gcswales/6502-CRAB-APPLE/ELECTRONICS/6502_SBC.jpg

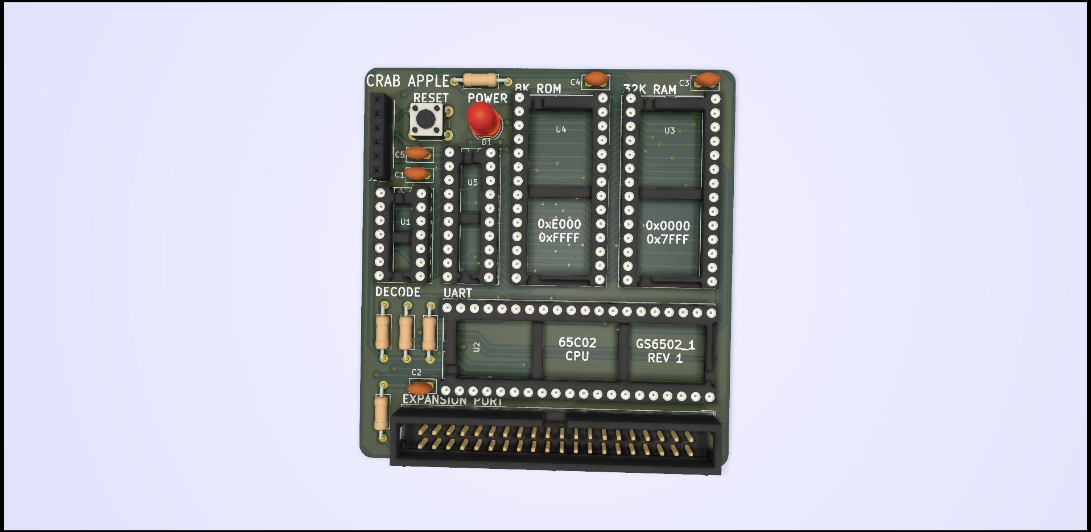
ELECTRONICS/6502_SBC.jpg
