gcswales/6502-CRAB-APPLE/ELECTRONICS/MEMORY_MAP3.odt

A15 A14 A13 RAM_CS RAM_OE ROM_CS ROM_OE IO_CS DESCRIPTION

1 1 1 1 1 0 0 1 ROM 4K

1 1 1 1 1 0 0 1 ROM 4K

1 1 0 1 1 0 1 0 I/O

1 1 0 1 1 0 1 0 I/O

1 0 1 1 1 1 1 1 FREE

1 0 1 1 1 1 1 1 FREE

1 0 0 1 1 1 1 1 FREE

1 0 0 1 1 1 1 1 FREE

0 1 1 0 0 1 0 1 RAM 4K

0 1 1 0 0 1 0 1 RAM 4K

0 1 0 0 0 1 1 0 RAM 4K

0 1 0 0 0 1 1 0 RAM 4K

0 0 1 0 0 1 1 1 RAM 4K

0 0 1 0 0 1 1 1 RAM 4K

0 0 0 0 0 1 1 1 RAM 4K

0 0 0 0 0 1 1 1 RAM 4K

0xE000 – 0xFFFF - ROM

0xC000 – 0xDFFF - I/O

0x8000 – 0xBFFF - FREE

0x0000 – 0x7FFF - RAM

SPECIFICALLY THE UART IS MAPPED TO 0xC010 AND 0xC011 (A4 LINE).

A15 | A14 | A13 | A12 | A11 | A10 | A9 | A8 | A7 | A6 | A5 | A4 | A3 | A2 | A1 | A0 | ADDRESS | DESCRIPTION
1 | 1 | 1 | x | x | x | x | x | x | x | x | x | x | x | x | x | 0xE000 - 0xFFFF | 8K ROM
1 | 1 | 0 | x | x | x | x | x | x | x | x | x | x | x | x | x | 0xC000 - 0xDFFF | 8K I/O MAPPED RANGE
1 | 0 | x | x | x | x | x | x | x | x | x | x | x | x | x | x | 0x8000 – 0xBFFF | 16K FREE
0 | x | x | x | x | x | x | x | x | x | x | x | x | x | x | x | 0x0000 – 0x7FFF | 32K RAM
1 | 1 | 0 | x | x | x | x | x | x | x | x | 1 | x | x | x | 0 | N/A | UART ADDRESS 0
1 | 1 | 0 | x | x | x | x | x | x | x | x | 1 | x | x | x | 1 | N/A | UART ADDRESS 1
