gcswales/6502-CRAB-APPLE/ELECTRONICS/BOM/6502_SBC.ods

Id | Designator | Package | Quantity | Designation | Manufacturer | Manufacturer Code | Supplier | Supplier Code | Cost | Total | Comments
1 | D1 | LED_D5.0mm | 1 | LED | CREE LED | C503B-RBN-CW0Z0AA2 | MOUSER | 941-C503BRBNCW0Z0AA2 | £0.130 | £0.130 | POWER LED
2 | J2 | IDC-Header_2x20_P2.54mm_Vertical | 1 | Conn_02x20_Odd_Even | 3M ELECTRONIC | 30340-6002HB | MOUSER | 517-30340-6002 | £1.360 | £1.360 | EXPANSION BUS CONNECTOR
3 | U1 | DIP-14_W7.62mm_Socket_LongPads | 1 | 7400 | TEXAS INSTRUMENTS | SN74HC00AN | MOUSER | 595-SN74HC00AN | £0.528 | £0.528 | ADDRESS DECODE LOGIC (4XNAND)
4 | SW1 | SW_PUSH_6mm | 1 | SW_Push | CUI DEVICES | TS02-66-55-BK-160-LCR-D | MOUSER | 179-TS026655BK160LCR | £0.088 | £0.088 | RESET BUTTON
5 | R5,R2,R1,R4,R3 | R_Axial_DIN0207_L6.3mm_D2.5mm_P10.16mm_Horizontal | 5 | 1K | YAGEO | CFR-25JB-1K0 | MOUSER | 603-CFR-25JB-1K0 | £0.088 | £0.440 | RESISTORS
6 | J1 | PinSocket_1x06_P2.54mm_Vertical | 1 | Conn_01x06_Female | HARWIN | M20-7820646 | MOUSER | 855-M20-7820646 | £1.090 | £1.090 | ICSP CONNECTOR & USB/UART
7 | C4,C3,C2,C1,C5 | C_Disc_D5.0mm_W2.5mm_P2.50mm | 5 | 100N | VISHAY | K104M15X7RF53K2 | MOUSER | 594-K104M15X7RF53K2 | £0.202 | £1.010 | DECOUPLING CAPS
8 | U2 | DIP-40_W15.24mm_Socket_LongPads | 1 | 6502 | WESTERN DESIGN CENTRE | W65C02S6TPG-14 | MOUSER | 955-W65C02S6TPG-14 | £9.510 | £9.510 | 65C02 CPU
9 | U3 | DIP-28_W15.24mm_Socket_LongPads | 1 | AS6C62256-55PCN | ALLIANCE MEMORY | AS6C62256-55PCN | MOUSER | 913-AS6C62256-55PCN | £3.610 | £3.610 | 32K SRAM CHIP
10 | U4 | DIP-28_W15.24mm_Socket_LongPads | 1 |  | MICROCHIP | AT28C64B-15PU | MOUSER | 556-AT28C64B15PU | £5.140 | £5.140 | 8K EEPROM
11 | U5 | DIP-20_W7.62mm_Socket_LongPads | 1 | PIC18F14Q41 | MICROCHIP | PIC18F14Q40-I/P | MOUSER | 579-PIC18F14Q40-I/P | £1.610 | £1.610 | PIC18F – BIOS
12 | U1 | DIP-14_W7.62mm_Socket_LongPads | 1 | 14-PIN IC SOCKET | MILL-MAX | 110-44-314-41-001000 | MOUSER | 575-11044314 | £0.915 | £0.915 | 14-PIN IC SOCKET (7400)
13 | U2 | DIP-40_W15.24mm_Socket_LongPads | 1 | 40-PIN IC SOCKET | MILL-MAX | 110-44-640-41-001000 | MOUSER | 575-11044640 | £2.220 | £2.220 | 40-PIN IC SOCKET (CPU)
14 | U3,U4 | DIP-28_W15.24mm_Socket_LongPads | 2 | 28-PIN IC SOCKET | MILL-MAX | 110-99-628-41-001000 | MOUSER | 575-199628 | £1.680 | £3.360 | 28-PIN IC SOCKET (RAM & ROM)
15 | U5 | DIP-20_W7.62mm_Socket_LongPads | 1 | 20-PIN IC SOCKET | MILL-MAX | 110-99-320-41-001000 | MOUSER | 575-199320 | £1.200 | £1.200 | 20-PIN IC SOCKET (PIC18)
 |  |  |  |  |  |  |  |  |  | £32.211
 |  | PRICES & AVAILABILITY AS OF 13/01/23
