gcswales/6502-CRAB-APPLE/(threads)

Thread 1 (2023-12-04):

W65C02 Pin 1 ?

Mike-K8LH, 2023-12-04:
It seems pin 1 on non-WDC CPU's is VSS (ground) but pin 1 on WDC CPU's is an output.  Shouldn't that pin be 'open' or 'no connect' instead of grounded when using WDC CPU's?

gcswales, 2023-12-06:
> It seems pin 1 on non-WDC CPU's is VSS (ground) but pin 1 on WDC CPU's is an output. Shouldn't that pin be 'open' or 'no connect' instead of grounded when using WDC CPU's?

Aaaaah!
You're right.
Best thing is there's no 'one size fits all' solution. I'll amend the documentation to make this clear.
It will only be a problem when trying to use interrupts and WOZ didn't like the 6502 interrupts.
Possible work-around (botch) is to bend pin 1 when fitting the 6502 so pin 1 does not sit in the DIP socket contact.
best regards,
Geoffrey.

Mike-K8LH, 2023-12-06:
Greetings, Geoffrey:

May I say this is a 'brilliant' project? Thank you. I built a board and installed Krusader 1.3 firmware and it seems to work quite well, except I'm not sure Xon/Xoff is working correctly. If you have time, may I impose to ask a couple questions, please?

(1) Which versions of MPLABX and XC8 did you use? I'm using MPLABX version 6.10 with XC8 version 2.45 and getting some "conflicting type" errors for 'putch' and 'getch' functions when compiling the program. I changed the type for those functions in order to compile without errors.

(2) Which PIC device did you use? The schematic shows 18F15Q41 but the project file seems to be for the 18F14Q40. I'm actually using 18F16Q40 but I'm not sure it's 100% compatible with your program, as is.

(3) Should the 256 byte RX buffer and Xon/Xoff method allow me to download large programs (text) without having to use character and line delays in my TeraTerm terminal program?

Please don't feel obligated to answer. I will understand.

Cheerful regards, Mike McLaren, K8LH (Michigan, USA)

From: "Geoffrey Swales" ***@***.***>
To: "gcswales/6502-CRAB-APPLE" ***@***.***>
Cc: "Mike-K8LH" ***@***.***>, "Author" ***@***.***>
Sent: Wednesday, December 6, 2023 8:58:10 AM
Subject: Re: [gcswales/6502-CRAB-APPLE] W65C02 Pin 1 ? (Issue #1)

It seems pin 1 on non-WDC CPU's is VSS (ground) but pin 1 on WDC CPU's is an output. Shouldn't that pin be 'open' or 'no connect' instead of grounded when using WDC CPU's?

Aaaaah!
You're right.
Best thing is there's no 'one size fits all' solution. I'll amend the documentation to make this clear.
It will only be a problem when trying to use interrupts and WOZ didn't like the 6502 interrupts.
Possible work-around (botch) is to bend pin 1 when fitting the 6502 so pin 1 does not sit in the DIP socket contact.
best regards,
Geoffrey.

—
Reply to this email directly, [ https://github.com/gcswales/6502-CRAB-APPLE/issues/1#issuecomment-1842943363 | view it on GitHub ] , or [ https://github.com/notifications/unsubscribe-auth/AJGRSDVY5FPEUTNZUYEHWNTYIB2XFAVCNFSM6AAAAABAGM4BASVHI2DSMVQWIX3LMV43OSLTON2WKQ3PNVWWK3TUHMYTQNBSHE2DGMZWGM | unsubscribe ] .
You are receiving this because you authored the thread. Message ID: ***@***.***>

Mike-K8LH, 2023-12-06:
BTW, Geoffrey, I use a jumper on pin 1 to ground (the yellow jumper below) to support both WDC and non-WDC CPU's.

Take care. Cheerful regards, Mike McLaren

gcswales, 2023-12-15:
Hi Mike,

Thanks for that; compliments are ALWAYS welcome!

I'm at work at the moment but I will look into the XON/XOFF issue. I know it was working when I tested it as it became evident early on that some type of flow control was needed when trying to 'paste' code using WOZMON. Initially I used RTS/CTS but ran out of pins on the PIC so resorted to XON/XOFF which works well with the type of ASCII data the Apple I was limited to (7-bits).

3) The 256 rx buffer solves a problem with cheaper USB2UART modules that only respond to flow-control between USB packets, so they will continue to dump their current data packet before halting. The XON/XOFF is to stem the flow when it is a large torrent of data.

2) 18f15q41... maybe another mistake. I'll look into this. I know I changed the PIC a few times during development. Using at 18f14q40 (16k/1k) or a 18f16q40 (64k/4k) should not make a difference. Both devices have identical peripherals it's only a memory difference.

1) I'll get back to you on that. I remember that Microchip changed some definitions in it's XC.H file for the newer versions of XC8 which was very annoying. Also they promote the use of universal variable types; for example U8INT, S32INT as these are portable across different platforms and processor sizes. However, in their libraries they continue to use things like LONG SHORT LONG, etc!?!

I've never heard of Krusader 1.3 but I've just Googled it and it sounds interesting so I'll give it a go.

I would be interested to hear any ideas for improvement on the Crab Apple. It was a 'first attempt' and since then I've been working on something a bit more sophisticated. However, I'd like to go back a revise the Crab Apple to produce the Crab Apple II. Rather than use an EPROM I fit 2 x 32k SRAM. The PIC uploads the EPROM images via Xmodem then pumps it to the SRAM during boot (takes 0.6ms). This speeds up development and makes the whole thing a bit more flexible.

Let me know how you get on.

Best regards,

Geoffrey.

gcswales, 2023-12-15:
Hi Mike,
To answer your first question:
Hi Mike,

I'm using MPLAB X IDE v6.00 on Mint Linux so it may be a different version on Windows.

The code is written in C using Microchip XC8 v2.36.

Mike-K8LH, 2023-12-15:
I have ideas and some working examples.  Crab Apple I only lacks a pin to enable/disable memory in order to support boot loader, rom emulator, and programmer functions.  I have something like this using a Nano (see below).  Crab Apple II might benefit from using a 28-pin 18F27Q43.

Interested in communicating directly?  k8lh and arrl.net

Cheerful regards...  Happy Holidays...

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

micha-uhl, 2024-09-24:
Hallo, I´m Michael, 69. Very interesting version of the Apple1. I have ordered some PCBs from pcbway. I have also build the RC6502 Apple 1 replica. So I have a second MOS6502 and EEPROM with Basic, Crusader and Wozmon over. Now I'm looking for someone who can program the PIC for me.
regards

Mike-K8LH, 2024-09-24:
Hi, Michael.

May I ask where you're located, please? If you're in the United States, perhaps I can help.

Cheerful regards,

Mike McLaren, K8LH (Michigan, USA)

From: "micha-uhl" ***@***.***>
To: "gcswales/6502-CRAB-APPLE" ***@***.***>
Cc: "Mike-K8LH" ***@***.***>, "Author" ***@***.***>
Sent: Tuesday, September 24, 2024 10:04:05 AM
Subject: Re: [gcswales/6502-CRAB-APPLE] W65C02 Pin 1 ? (Issue #1)

Hallo, I´m Michael, 69. Very interesting version of the Apple1. I have ordered some PCBs from pcbway. I have also build the RC6502 Apple 1 replica. So I have a second MOS6502 and EEPROM with Basic, Crusader and Wozmon over. Now I'm looking for someone who can program the PIC for me.
regards

—
Reply to this email directly, [ https://github.com/gcswales/6502-CRAB-APPLE/issues/1#issuecomment-2371390692 | view it on GitHub ] , or [ https://github.com/notifications/unsubscribe-auth/AJGRSDTJOR66ZVAR37WPVIDZYFWNLAVCNFSM6AAAAABOYMQI6KVHI2DSMVQWIX3LMV43OSLTON2WKQ3PNVWWK3TUHMZDGNZRGM4TANRZGI | unsubscribe ] .
You are receiving this because you authored the thread. Message ID: ***@***.***>

micha-uhl, 2024-09-24:
Sorry, I´m from Germany

gcswales, 2024-09-24:
Hi Michael,
If you send me your address I'll ship you one.
Best regards,
Geoffrey.

micha-uhl, 2024-09-24:
Hi Geoffrey, that's great. Sent you Email.
regards Michael

Mike-K8LH, 2024-09-25:
Hi Geoffrey.  Would you consider opening up the 'discussions' tab on your github project?  I'd love to talk about some ideas, if you have the time and interest.

Cheerful regards...

micha-uhl, 2024-09-25:
One more question, can I also use an 8x8 SRAM? That would be closer to the original.

Regards Michael

gcswales, 2024-09-25:
Hi Michael,  yes you can fit an 8k x 8 SRAM. The address will wrap-around so the 8k will appear 4 times in the 32k space.
However, 8k SRAM is probably more expensive (rare) than 32k chips and you will be limiting what programs you can run.
I have a newer design which uses 2 x 32k SRAM chips and the PIC dumps the an 8k ROM image into RAM during boot. It takes about 200ms. Also the PIC runs XMODEM so I can quickly upload code to the board which is much faster, when developing code, than pulling an EEPROM out and programming it.

gcswales, 2024-09-26:
> Hi Geoffrey. Would you consider opening up the 'discussions' tab on your github project? I'd love to talk about some ideas, if you have the time and interest.
>
> Cheerful regards...

Done, hit me!

micha-uhl, 2024-10-15:
Now I have finished the part, but it doesn't work properly.
1. Problem, no LF. I can set it in Windows with TeraTerm
2. The boot menu is displayed and I can also make settings. After the start, the backslash appears. No keyboard inputs are accepted.
3. I used an 8k x 8 SRAM. It may be that it doesn't work because of that. I have ordered a 62256 to see, what happens.

gcswales, 2024-10-15:
Hi Michael,
1) WOZMON and many apple I programs only send CR and do not follow it with a LF. The PIC firmware also does this or it would appear double spaced. Also the serial port uses XON/XOFF so you will need to set software flow control. People use WOZMON to cut & paste applications onto the terminal, which is quite a rush of data. Just the 256 byte receive buffer alone is not enough to cope with this so flow control is required or data will be lost.
2) Once you quit the menu the system just resets and runs the 6502. The 6502 will run whatever is on your EPROM. You may want to double check your EPROM code.
3) Yes, on reflection, using an 8k SRAM will cause the memory to roll-over and so the 8k RAM will appear 4 times in the 32k space. This means the stack (page 1) will also appear 4 times and if you write over the stack the software will act erratically.

micha-uhl, 2024-10-16:
Hi, no I found the mistaken! The 6264 has a second CS on pin 26, which must be connected to Vcc. With minicom I also found a Linux terminal where I can make the settings. Of course, it would be nicer if the CR+LF could be set via the boot menu. All my other SBC replicas have CR+LF

Greetings Micha
