gcswales/6502-CRAB-APPLE/ELECTRONICS/CRAB_APPLE_I.pdf

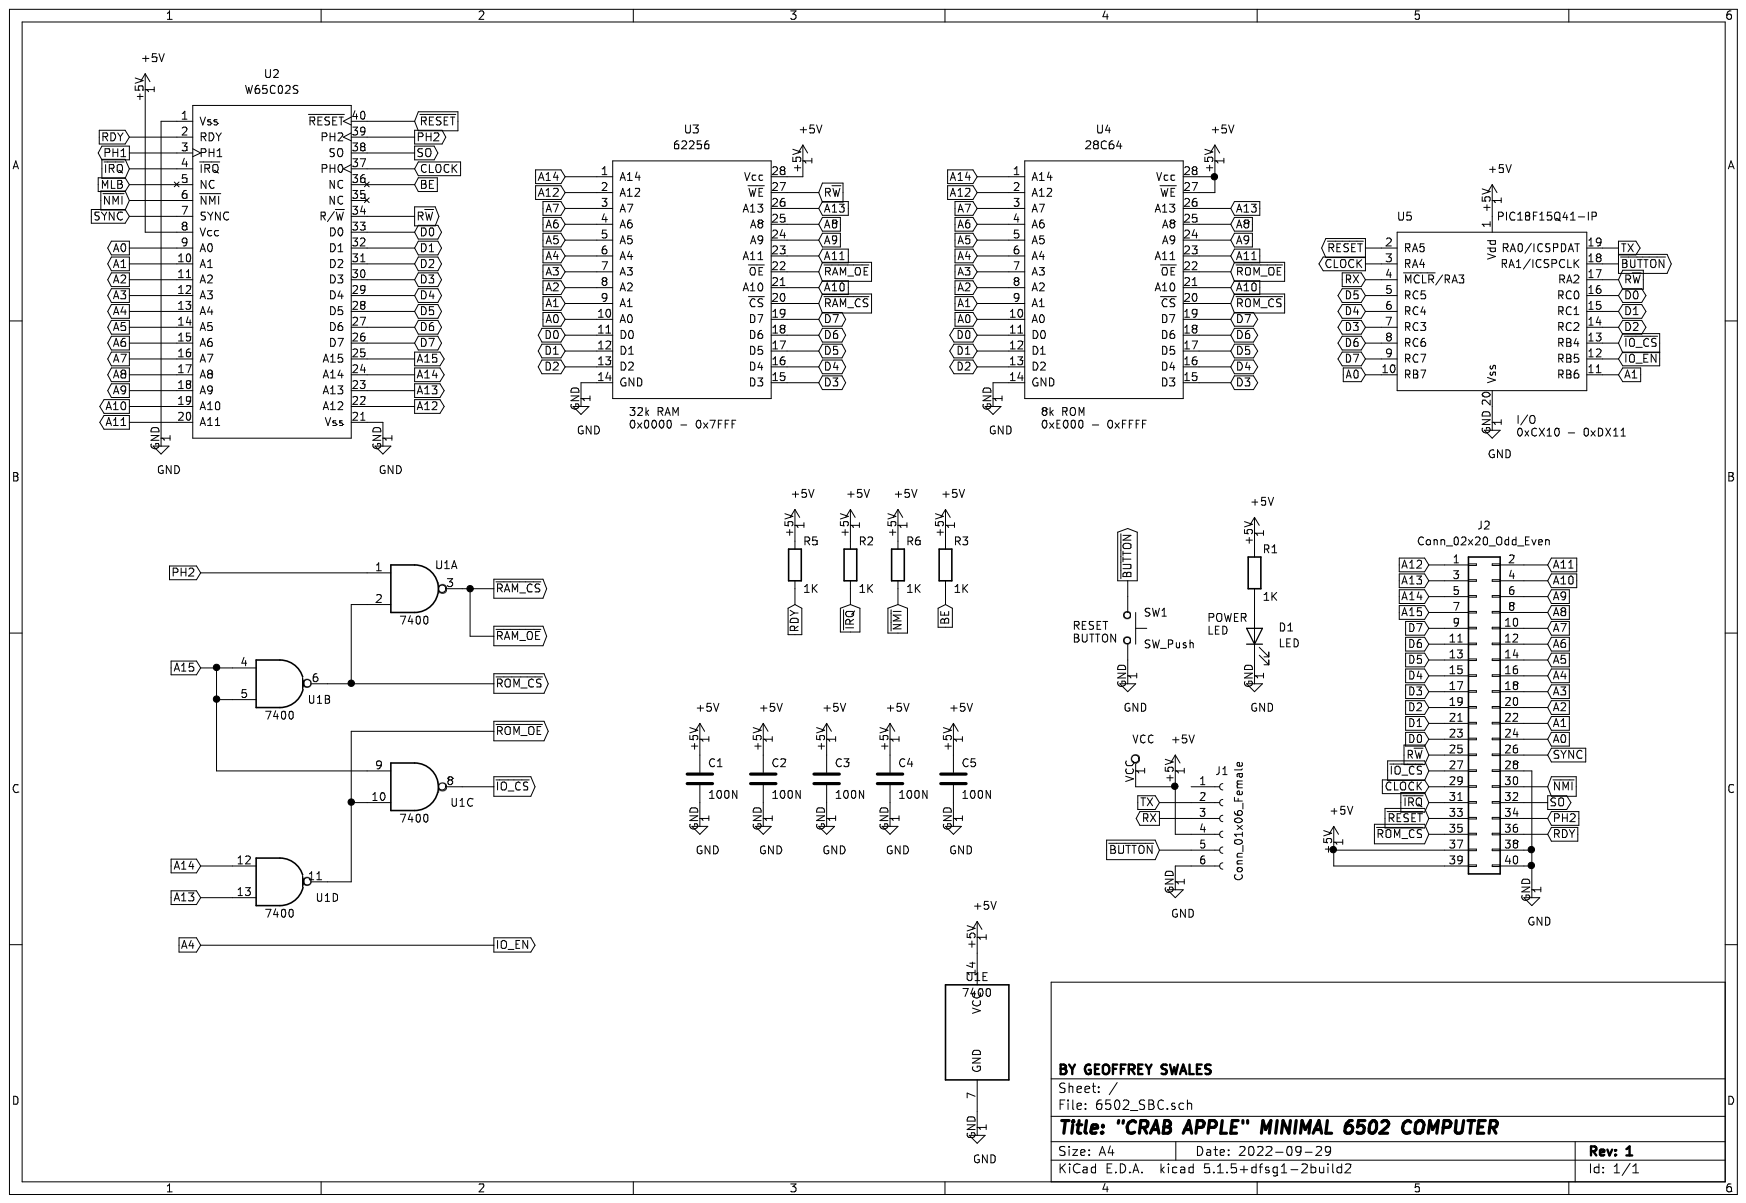
[picture p2: page 1]
