gcswales/6502-CRAB-APPLE/ELECTRONICS/6502_SBC.kicad_pcb

## KiCad design ELECTRONICS/6502_SBC.kicad_pcb (2023-01-16)

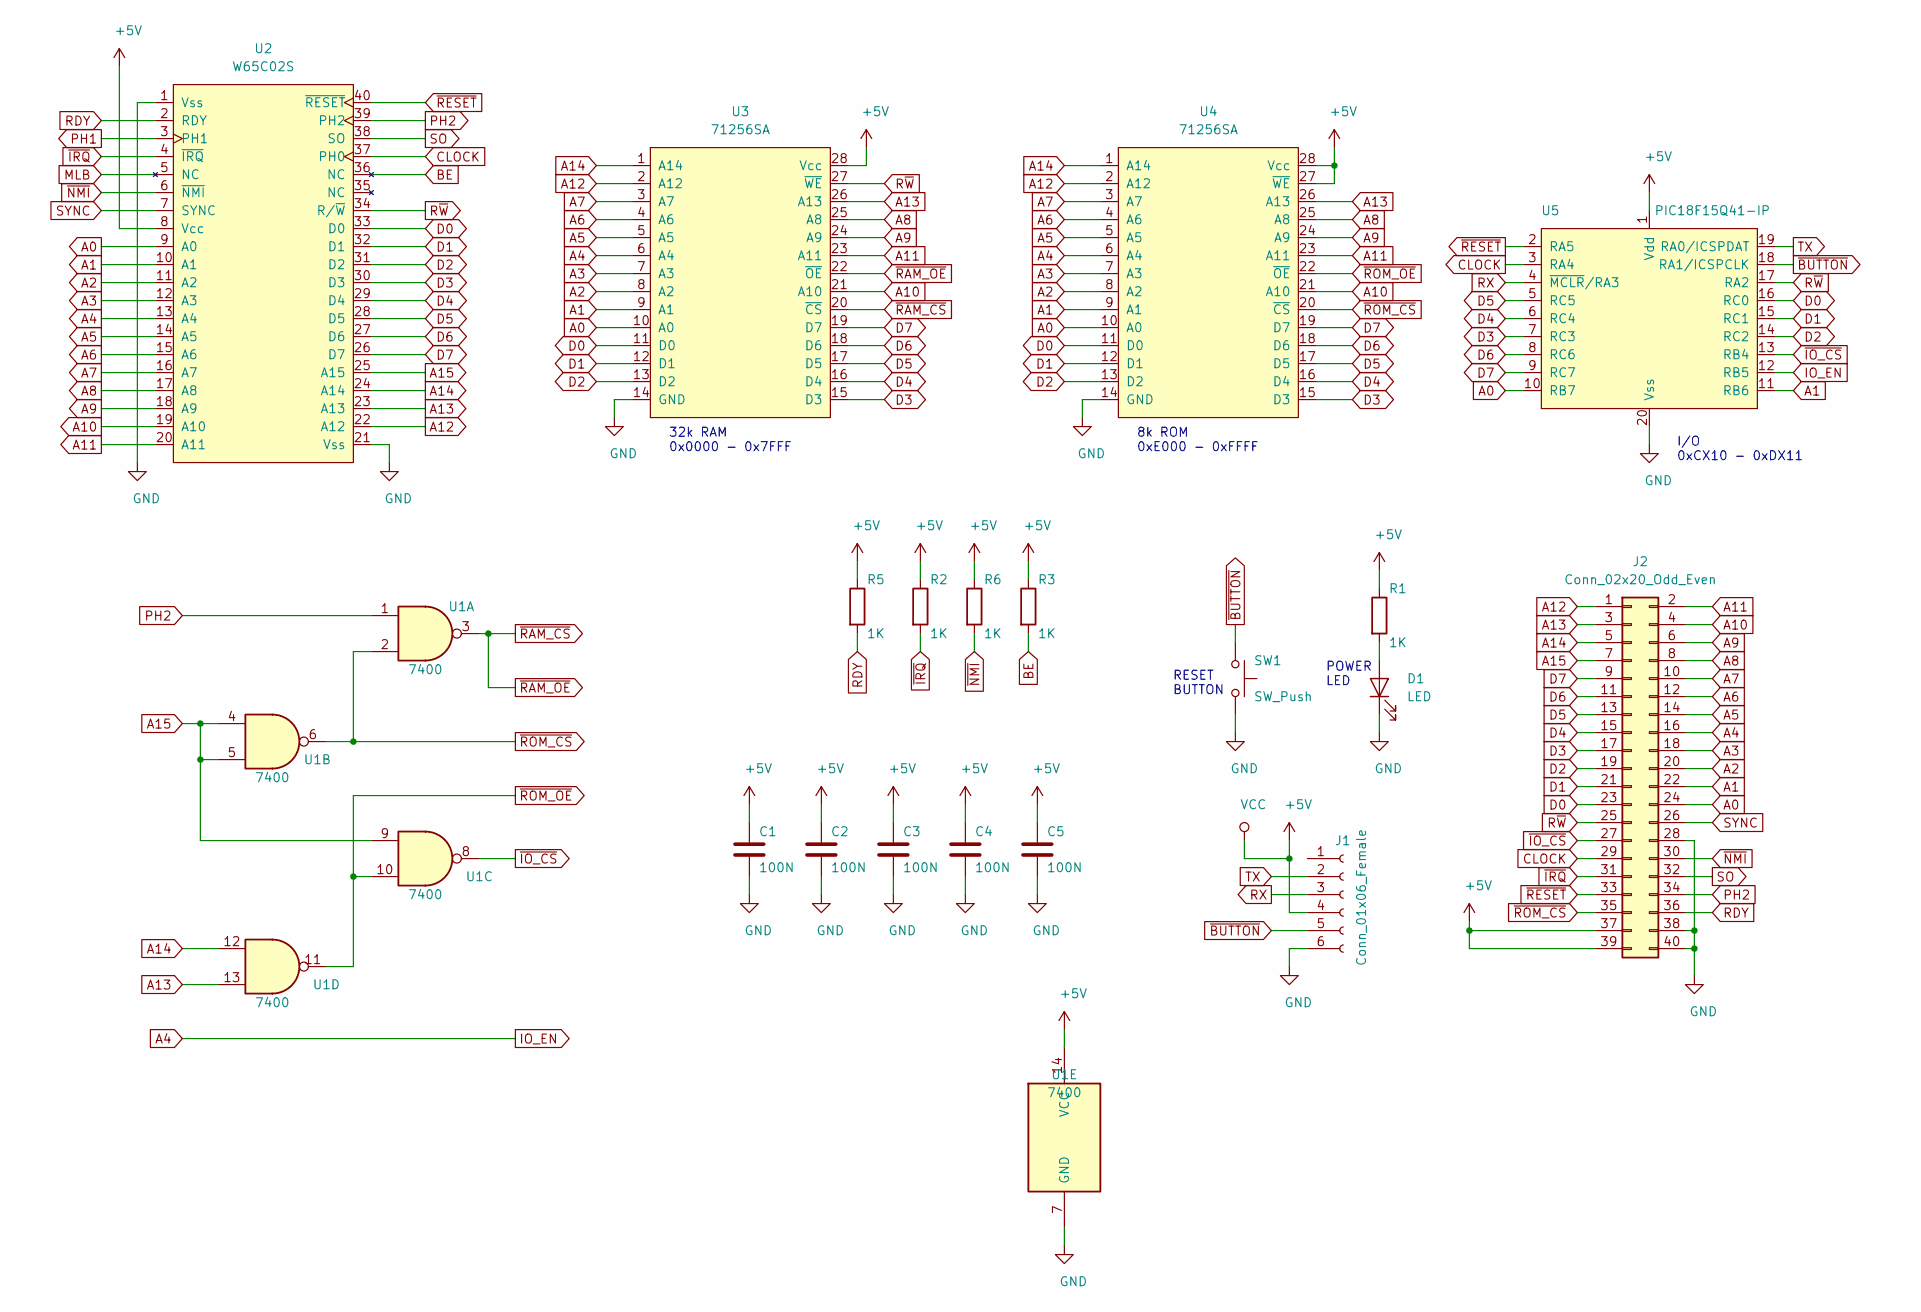
[picture p3: schematic 6502_SBC.sch, \"CRAB APPLE\" MINIMAL 6502 COMPUTER]

Parts:
C1, C2, C3, C4, C5: 100N; C_Disc_D5.0mm_W2.5mm_P2.50mm
D1: LED; LED_D5.0mm
J1: Conn_01x06_Female; PinSocket_1x06_P2.54mm_Vertical
J2: Conn_02x20_Odd_Even; IDC-Header_2x20_P2.54mm_Vertical
R1, R2, R3, R5, R6: 1K; R_Axial_DIN0207_L6.3mm_D2.5mm_P10.16mm_Horizontal
SW1: SW_Push; SW_PUSH_6mm
U1: 7400; DIP-14_W7.62mm_Socket_LongPads
U2: W65C02S; DIP-40_W15.24mm_Socket_LongPads
U3, U4: 71256SA; DIP-28_W15.24mm_Socket_LongPads
U5: PIC18F15Q41-IP; DIP-20_W7.62mm_Socket_LongPads

Connections:
+5V: C1.1, C2.1, C3.1, C4.1, C5.1, J1.4, J2.37, J2.39, R1.1, R2.1, R3.1, R5.1, R6.1, U1.14 (VCC), U2.8 (Vcc), U3.28 (Vcc), U4.27 (~WE~), U4.28 (Vcc), U5.1 (Vdd)
A0: J2.24, U2.9 (A0), U3.10 (A0), U4.10 (A0), U5.10 (RB7)
A1: J2.22, U2.10 (A1), U3.9 (A1), U4.9 (A1), U5.11 (RB6)
A2: J2.20, U2.11 (A2), U3.8 (A2), U4.8 (A2)
A3: J2.18, U2.12 (A3), U3.7 (A3), U4.7 (A3)
A4: J2.16, U2.13 (A4), U3.6 (A4), U4.6 (A4), U5.12 (RB5)
A5: J2.14, U2.14 (A5), U3.5 (A5), U4.5 (A5)
A6: J2.12, U2.15 (A6), U3.4 (A6), U4.4 (A6)
A7: J2.10, U2.16 (A7), U3.3 (A7), U4.3 (A7)
A8: J2.8, U2.17 (A8), U3.25 (A8), U4.25 (A8)
A9: J2.6, U2.18 (A9), U3.24 (A9), U4.24 (A9)
A10: J2.4, U2.19 (A10), U3.21 (A10), U4.21 (A10)
A11: J2.2, U2.20 (A11), U3.23 (A11), U4.23 (A11)
A12: J2.1, U2.22 (A12), U3.2 (A12), U4.2 (A12)
A13: J2.3, U1.13, U2.23 (A13), U3.26 (A13), U4.26 (A13)
A14: J2.5, U1.12, U2.24 (A14), U3.1 (A14), U4.1 (A14)
A15: J2.7, U1.4, U1.5, U1.9, U2.25 (A15)
BE: R3.2, U2.36 (NC)
CLOCK: J2.29, U2.37 (PH0), U5.3 (RA4)
D0: J2.23, U2.33 (D0), U3.11 (D0), U4.11 (D0), U5.16 (RC0)
D1: J2.21, U2.32 (D1), U3.12 (D1), U4.12 (D1), U5.15 (RC1)
D2: J2.19, U2.31 (D2), U3.13 (D2), U4.13 (D2), U5.14 (RC2)
D3: J2.17, U2.30 (D3), U3.15 (D3), U4.15 (D3), U5.7 (RC3)
D4: J2.15, U2.29 (D4), U3.16 (D4), U4.16 (D4), U5.6 (RC4)
D5: J2.13, U2.28 (D5), U3.17 (D5), U4.17 (D5), U5.5 (RC5)
D6: J2.11, U2.27 (D6), U3.18 (D6), U4.18 (D6), U5.8 (RC6)
D7: J2.9, U2.26 (D7), U3.19 (D7), U4.19 (D7), U5.9 (RC7)
GND: C1.2, C2.2, C3.2, C4.2, C5.2, D1.1 (K), J1.6, J2.28, J2.38, J2.40, SW1.2, U1.7 (GND), U2.1 (Vss), U2.21 (Vss), U3.14 (GND), U4.14 (GND), U5.20 (Vss)
unnamed: D1.2 (A), R1.2
PH2: J2.34, U1.1, U2.39 (PH2)
RDY: J2.36, R5.2, U2.2 (RDY)
RX: J1.3, U5.4 (~MCLR~/RA3)
R~W~: J2.25, U2.34 (R/~W~), U3.27 (~WE~), U5.17 (RA2)
SO: J2.32, U2.38 (SO)
SYNC: J2.26, U2.7 (SYNC)
TX: J1.2, U5.19 (RA0/ICSPDAT)
~BUTTON~: J1.5, SW1.1, U5.18 (RA1/ICSPCLK)
~IO_CS~: J2.27, U1.8, U5.13 (RB4)
~IRQ~: J2.31, R2.2, U2.4 (~IRQ)
~NMI~: J2.30, R6.2, U2.6 (~NMI)
~RAM_CS~: U1.3, U3.20 (~CS~), U3.22 (~OE~)
~RESET~: J2.33, U2.40 (~RESET~), U5.2 (RA5)
~ROM_CS~: J2.35, U1.2, U1.6, U4.20 (~CS~)
~ROM_OE~: U1.10, U1.11, U4.22 (~OE~)

Notes on the sheet:
32k RAM 0x0000 - 0x7FFF
8k ROM 0xE000 - 0xFFFF
I/O 0xCX10 - 0xDX11
POWER LED
RESET BUTTON

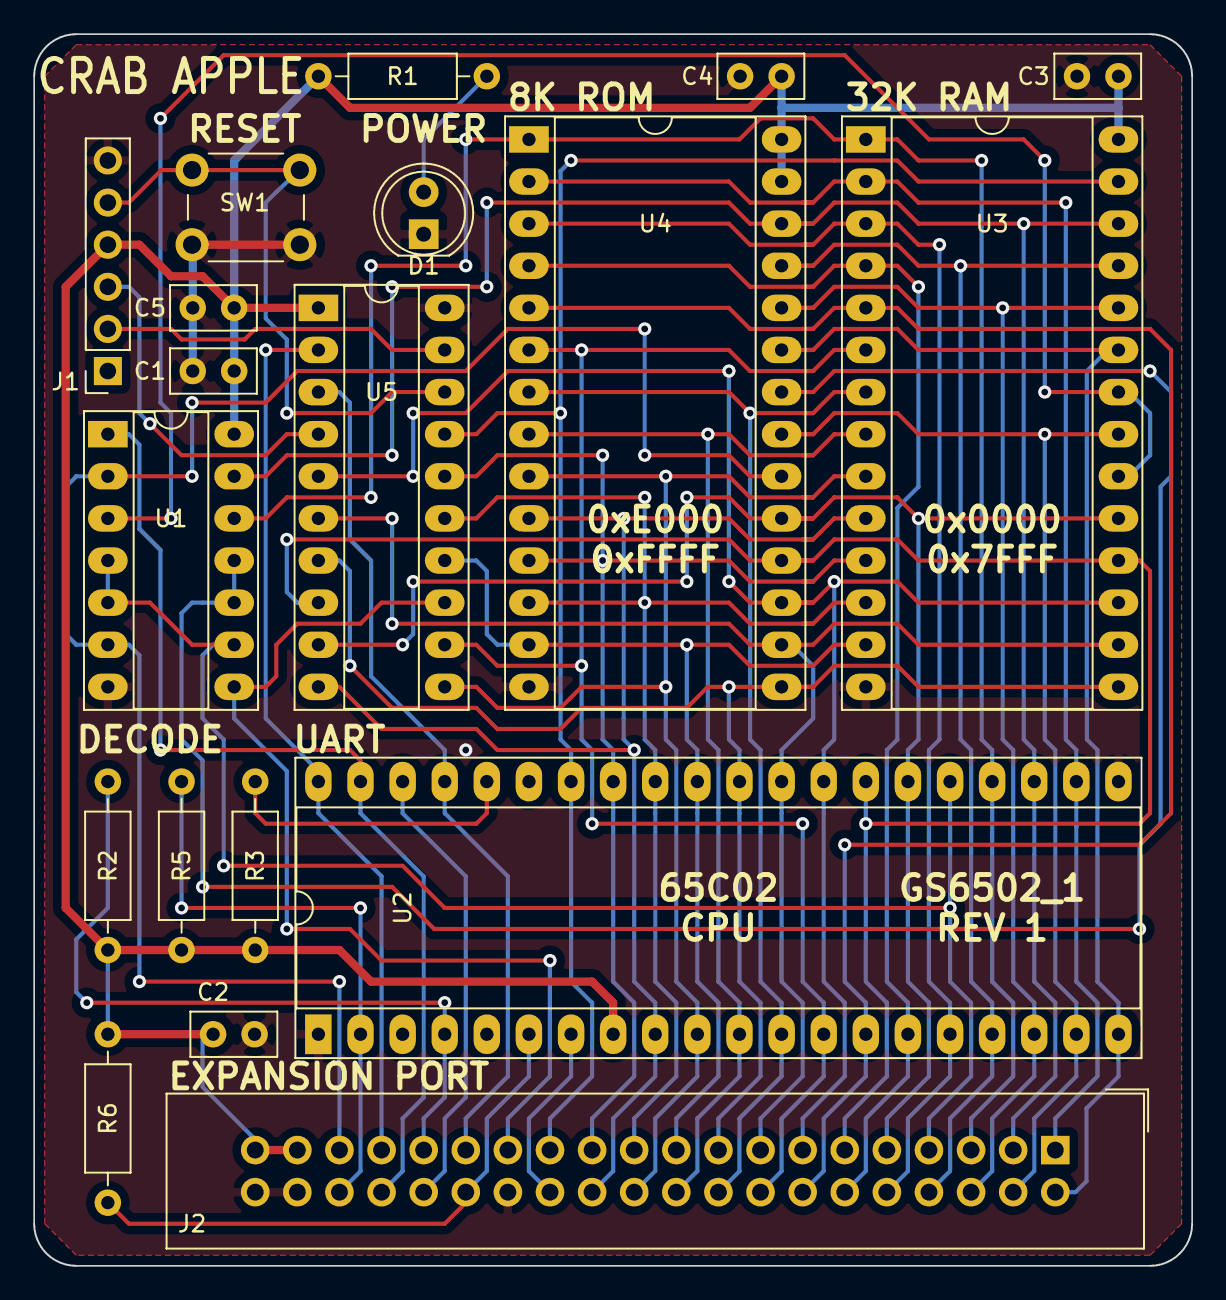
[picture p4: board 6502_SBC.kicad_pcb from above]

Board: 2 copper layers, 69.9 x 74.3 mm, 19 parts (0 on the bottom side), 44 nets.
