gcswales/6502-CRAB-APPLE/FIRMWARE/CRAB_APPLE_BIOS.X/CLOCK.h

//*************************************************************
//***	FILE:		CLOCK.H									***
//***	DATE:		09/09/21								***
//***	AUTHOR:		GEOFFREY SWALES							***
//***	VERSION:	V0.1									***
//*************************************************************
//***	DESCRIPTION:										***
//***	SIMPLE PROTOTHREADS									***
//*************************************************************
//***	VERSION TRACK:										***
//***	V0.1: INITIAL DEVELOPMENT VERSION					***
//***	V1.0:												***
//*************************************************************
//
//
//*************************************************************
//*** REDEFINITION BLOCKING ***********************************
//*************************************************************
//
#ifndef _CLOCK_H_										    // if not defined already
#define	_CLOCK_H_										    // define it so we don't do it again
//
//*************************************************************
//*** INCLUDE USEFUL COMPILER DEFINTIONS **********************
//*************************************************************
//
#include <xc.h>												// lots of useful definitions for xc16 compiler
#include <stdint.h>											// nice standard variable definitions used in this file
#include <stdbool.h>
//
//*************************************************************
//*** USEFUL DEFINITIONS **************************************
//*************************************************************
//
#define CLKREF_1MHZ		0x6									// define value for 1MHz clock
#define CLKREF_2MHZ		0x5									// define value for 2MHz clock
#define CLKREF_4MHZ		0x4									// define value for 4MHz clock
#define CLKREF_8MHZ		0x3									// define value for 8MHz clock (maybe in the future!)
//
//*************************************************************
//*** DECLARE ANY EXTERNAL GLOBAL VARIABLES *******************
//*************************************************************
//

//
//*************************************************************
//*** STRUCTURE DEFINITIONS ***********************************
//*************************************************************
//

//
//*************************************************************
//*** PROTOTYPE FUNCTIONS *************************************
//*************************************************************
//
void clock_init( void );									// initialise CPU clock hardware
void clock_set( uint8_t f );								// enable clock with frequency f
//
//*************************************************************
//*** MACROS TO MAKE LIFE EASIER ******************************
//*************************************************************
//

//
//*************************************************************
//*** END OF REDEFINITION BLOCKING ****************************
//*************************************************************
//
#endif														// end of redefine blocking
//
//*************************************************************
//*** END OF FILE *********************************************
//*************************************************************
//
